Kosana66/LED_panik_svetlo/Slika projekta uz napajanje.jpg

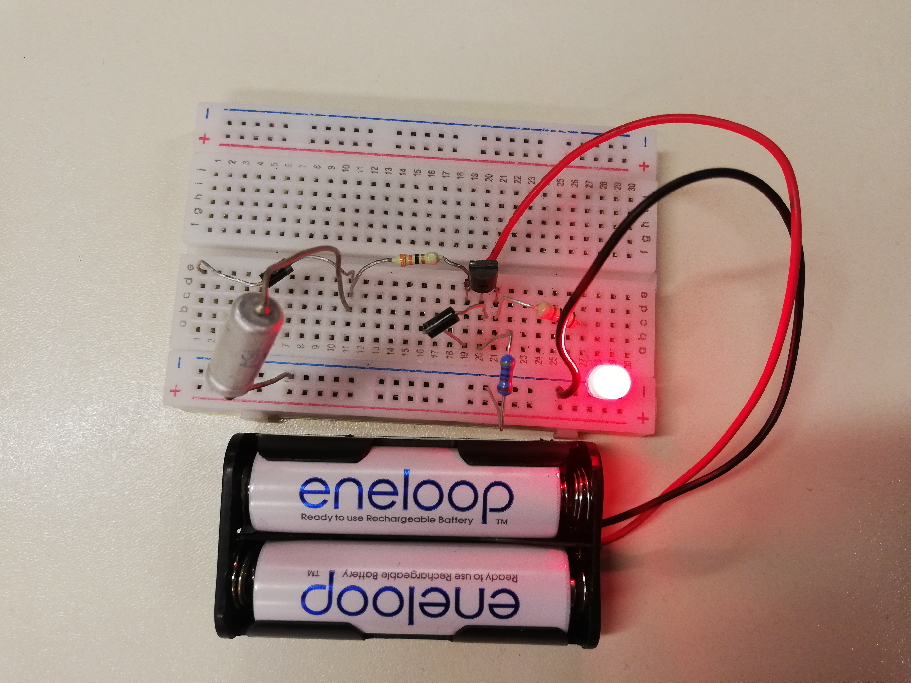
Slika projekta uz napajanje.jpg
