Kosana66/LED_panik_svetlo/(list of files, drawings)

Other design files:
altium/PCB2.PcbDoc
altium/PcbLib1.PcbLib
altium/projekat.PrjPcb
altium/Sheet1.SchDoc
