Kosana66/LED_panik_svetlo/Slika projekta bez napajanja.jpg

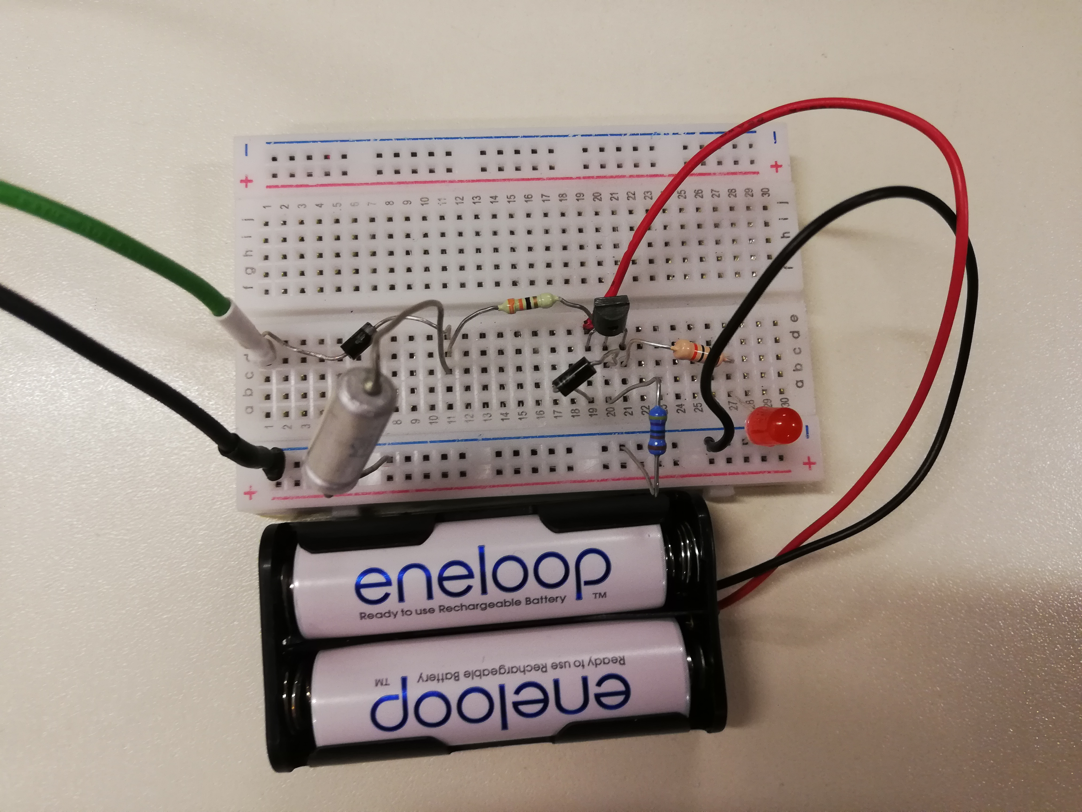
Slika projekta bez napajanja.jpg
